laszloh/musical-box/Hardware/Digikey_parts.xlsx

Refes | Description | Partnumber | Link | Supplier | Stückpreis | Menge | Gesamtpreis | Status
U202 | MP2615GQ-P | 1589-MP2615GQ-PCT-ND | https://www.digikey.at/products/de?keywords=1589-MP2615GQ-PCT-ND | Digi-Key | 2.19 | 1 | 2.19 | verfügbar
U203 | TPS56339 | 296-53568-1-ND | https://www.digikey.at/products/de?keywords=296-53568-1-ND | Digi-Key | 0.92 | 1 | 0.92 | verfügbar
U204/U205 | TLV75733PDBV | 296-50414-1-ND | https://www.digikey.at/products/de?keywords=296-53568-1-ND | Digi-Key | 0.42 | 2 | 0.84 | verfügbar
U206 | TLV803EC30DBZR | 296-TLV803EC30DBZRCT-ND | https://www.digikey.at/products/de?keywords=296-50414-1-ND | Digi-Key | 0.36 | 1 | 0.36 | verfügbar
U201 | STUSB4500QTR | 497-18060-1-ND | https://www.digikey.at/product-detail/de/stmicroelectronics/STUSB4500QTR/497-18060-1-ND/9092196 | Digi-Key | 1.73 | 1 | 1.73 | verfügbar
U401 | PCF8574ATS | 568-2030-1-ND | https://www.digikey.at/product-detail/de/nxp-usa-inc/PCF8574ATS-3-118/568-2030-1-ND/812995 | Digi-Key | 1.17 | 1 | 1.17 | verfügbar
U301 | CH340C |  |  | Digi-Key |  | 1 | 0 | nicht verfügabr
U302 | ESP32-WROVER | 1904-1015-1-ND | https://www.digikey.at/products/de?keywords=1904-1015-1-ND | Digi-Key | 4.08 | 0 | 0 | verfügbar
U501 / U502 | SPH0644HM4H-1 | 423-1426-1-ND | https://www.digikey.at/products/de?keywords=423-1426-1-ND | Digi-Key | 1.05 | 2 | 2.1 | verfügbar
U503 | TAS5754MDCA | 296-40564-1-ND | https://www.digikey.at/products/de?keywords=296-40564-1-ND | Digi-Key | 2.92 | 1 | 2.92 | verfügbar
D201 | NTS1045MFST1G | NTS1045MFST1GOSCT-ND | https://www.digikey.at/product-detail/de/on-semiconductor/NTS1045MFST1G/NTS1045MFST1GOSCT-ND/5022594 | Digi-Key | 0.48 | 1 | 0.48 | verfügbar
D204 | NTS1045MFST1G | NTS1045MFST1GOSCT-ND | https://www.digikey.at/product-detail/de/on-semiconductor/NTS1045MFST1G/NTS1045MFST1GOSCT-ND/5022594 | Digi-Key | 0.48 | 1 | 0.48 | verfügbar
Q201 | IRFHM9331TRPBF | IRFHM9331TRPBFCT-ND | https://www.digikey.at/products/de?keywords=IRFHM9331TRPBFCT-ND | Digi-Key | 0.51 | 1 | 0.51 | verfügbar
L202 | SRN6028-6R0M | SRN6028-6R0MCT-ND | https://www.digikey.at/product-detail/de/bourns-inc/SRN6028-6R0M/SRN6028-6R0MCT-ND/4867803 | Digi-Key | 0.38 | 1 | 0.38 | verfügbar
L201 | B82477G4222M000 | 495-77028-1-ND | https://www.digikey.at/product-detail/de/epcos-tdk-electronics/B82477G4222M000/495-77028-1-ND/8601605 | Digi-Key | 1.45 | 1 | 1.45 | verfügbar | 12,3X 12,3
L203 | SRN6028-3R9M | SRN6028-3R9MCT-ND | https://www.digikey.at/product-detail/de/bourns-inc/SRN6028-3R9M/SRN6028-3R9MCT-ND/4867801 | Digi-Key | 0.38 | 1 | 0.38 | verfügbar
P201 | USB4085-GF-A | 2073-USB4085-GF-ACT-ND | https://www.digikey.at/products/de?keywords=2073-USB4085-GF-ACT-ND | Digi-Key | 1.09 | 1 | 1.09 | verfügbar
Q204 | IRF9362TRPBF | IRF9362TRPBFCT-ND | https://www.digikey.at/product-detail/de/infineon-technologies/IRF9362TRPBF/IRF9362TRPBFCT-ND/2354219 | Digi-Key | 0.6 | 1 | 0.6 | verfügbar
Q301 | BC846BDW1T1G | BC846BDW1T1GOSCT-ND | https://www.digikey.at/product-detail/de/on-semiconductor/BC846BDW1T1G/BC846BDW1T1GOSCT-ND/1967038 | Digi-Key | 0.17 | 1 | 0.17 | verfügbar
L501 / L502 / L503 L504 | BWVS006060454R7ML1 | 2184-BWVS006060454R7ML1CT-ND | https://www.digikey.at/product-detail/de/chilisin-electronics/BWVS006060454R7ML1/2184-BWVS006060454R7ML1CT-ND/12141439 | Digi-Key | 0.31 | 4 | 1.24 | verfügbar
J502 / J503 | SJ-43516-SMT-TR | CP-43516SJCT-ND | https://www.digikey.at/products/de?keywords=CP-43516SJCT-ND | Digi-Key | 0.88 | 2 | 1.76 | verfügbar
J201 | 1760510000 | 281-1882-ND | https://www.digikey.at/products/de?keywords=281-1882-ND | Digi-Key | 0.43 | 1 | 0.43 | verfügbar
J501 | EB21A-04-D | 2057-EB21A-04-D-ND | https://www.digikey.at/products/de?keywords=2057-EB21A-04-D-ND | Digi-Key | 0.62 | 1 | 0.62 | verfügbar
J1 | BM02B-GHS-TBT(LF)(SN)(N) | 455-1578-1-ND | https://www.digikey.at/products/de?keywords=455-1578-1-ND | Digi-Key | 0.32 | 1 | 0.32 | verfügbar
J203 | 1760510000 | 281-1882-ND | https://www.digikey.at/products/de?keywords=281-1882-ND | Digi-Key | 0.43 | 1 | 0.43 | verfügbar
J401 | BM08B-GHS-TBT(LF)(SN)(N) | 455-1584-1-ND | https://www.digikey.at/products/de?keywords=455-1584-1-ND | Digi-Key | 0.43 | 1 | 0.43 | verfügbar
J402 /J403/J404/ J405 | BM04B-GHS-TBT(LF)(SN)(N) | 455-1580-1-ND | https://www.digikey.at/products/de?keywords=455-1580-1-ND | Digi-Key | 0.38 | 4 | 1.52 | verfügbar
 |  |  |  |  |  |  | 24.52
RS Components
C211;C212,C505, C506, C527, C528 | 22µF | 1206 | 35V | 788-3063 | https://at.rs-online.com/web/p/keramik-vielschichtkondensatoren/7883063/ | RS | 6
R212 | 100m | 1210 |  | 721-3168 | https://at.rs-online.com/web/p/smd-widerstande/7213168/ | RS | 1
C214, C215, C204, C208, C209; C503, C507, C517, C524, C518, C521 | 1µ | 0603 | 50V | 103-4110 | https://at.rs-online.com/web/p/keramik-vielschichtkondensatoren/1034110/ | RS | 11
C201, C207, C203 | 10µ | 0805 | 35V | 172-6888 | https://at.rs-online.com/web/p/keramik-vielschichtkondensatoren/1726888/ | RS | 3
C202 | 330µ | 10mm | 35V | 172-3820 | https://at.rs-online.com/web/p/aluminium-elektrolytkondensatoren/1723820/ | RS | 1
C222,C218 | 22µF | 0805 | 35V | 915-9334 | https://at.rs-online.com/web/p/keramik-vielschichtkondensatoren/9159334/ | RS | 2
R223 | 30R | 0603 |  | 666-1913 | https://at.rs-online.com/web/p/smd-widerstande/6661913/ | RS | 1
C219, C510, C519 | 100pF | 0603 | 50V | 264-4523 | https://at.rs-online.com/web/p/keramik-vielschichtkondensatoren/2644523/ | RS | 3
R219 | 30,9k | 0603 |  | 840-9228 | https://at.rs-online.com/web/p/smd-widerstande/8409228/ | RS | 1
C217, C220 | 22µF | 0603 | 10V | 144-9046 | https://at.rs-online.com/web/p/keramik-vielschichtkondensatoren/1449046/ | RS | 2
C221, C226, C301, C303, C402, C406 | 10µF | 0603 | 10V | 170-6168 | https://at.rs-online.com/web/p/keramik-vielschichtkondensatoren/1706168/ | RS | 6
R208 | 22k | 0603 |  | 566-973 | https://at.rs-online.com/web/p/smd-widerstande/0566973/ | RS | 1
R201,R215, R205,R222,R213,R214,R220, R211, R509, R513, R312, R407 | 10k | 0603 |  | 740-8892 | https://at.rs-online.com/web/p/smd-widerstande/7408892/ | RS | 12
R216,R209,R204 | 100k | 0603 |  | 213-2531 | https://at.rs-online.com/web/p/smd-widerstande/2132531/ | RS | 3
C213,C206,c224,C216,C223,C225,C227,C210,C205, C501, C502, C504, C526, C302, C305, C306, C304, C401, C404, C405, C403 | 100nF | 0603 | 50V | 133-5641 | https://at.rs-online.com/web/p/keramik-vielschichtkondensatoren/1335641/ | RS | 21
R202 | 470k | 0603 |  | 684-5543 | https://at.rs-online.com/web/p/smd-widerstande/6845543/ | RS | 1
R218,R217,R221,R207,R210, R305, R308, R401, R402, R403, R404, R405, R406, R105 | 1k | 0603 |  | 213-2266 | https://at.rs-online.com/web/p/smd-widerstande/2132266/ | RS | 14
R203,R302, R303 | 470R | 0603 |  | 679-0419 | https://at.rs-online.com/web/p/smd-widerstande/6790419/ | RS | 3
R206 | 100R | 0603 |  | 566-535 | https://at.rs-online.com/web/p/smd-widerstande/0566535/ | RS | 1
R512, R501, R504, R505, r101, R102, R103 | 10R | 0603 |  | 678-9695 | https://at.rs-online.com/web/p/smd-widerstande/6789695/ | RS | 7
R502 | 750k | 0603 |  | 862-7063 | https://at.rs-online.com/web/p/smd-widerstande/8627063/ | RS | 1
R503 | 150k | 0603 |  | 213-2553 | https://at.rs-online.com/web/p/smd-widerstande/2132553/ | RS | 1
C511, C512, C522, C525 | 2,2µF | 0603 | 50V | 170-6267 | 7365617263685F636173636164655F6F726465723D31267365617263685F696E746572666163655F6E616D653D4931384E525353746F636B4E756D626572267365617263685F6C616E67756167655F757365643D656E267365617263685F6D617463685F6D6F64653D6D61746368616C6C267365617263685F7061747465726 | RS | 4
C508, C513, C515, C520 | 220nF | 0603 | 50V | 790-0566 | https://at.rs-online.com/web/p/keramik-vielschichtkondensatoren/7900566/ | RS | 4
C509, C514, C516, C523 | 680nF | 0805 | 50V | 169-6725 | https://at.rs-online.com/web/p/keramik-vielschichtkondensatoren/1696725/ | RS | 4
R506, R507, R510, R511 | 3R3 | 0603 |  | 820-6966 | https://at.rs-online.com/web/p/smd-widerstande/8206966/ | RS | 4
C529, C530, C531, C532 | 10nF | 0603 | 50V | 264-4595 | https://at.rs-online.com/web/p/keramik-vielschichtkondensatoren/2644595/ | RS | 4
R508 | 46,4k | 0603 |  | 708-8921 | https://at.rs-online.com/web/p/smd-widerstande/7088921/ | RS | 1
R304, R309 | 220R | 0603 |  | 566-793 | https://at.rs-online.com/web/p/smd-widerstande/0566793/ | RS | 2
R106, R107 | 4,7k | 0603 |  | 740-8877 | https://at.rs-online.com/web/p/smd-widerstande/7408877/ | RS | 2
