laszloh/musical-box/Hardware/Housing/parts/Side.FCStd

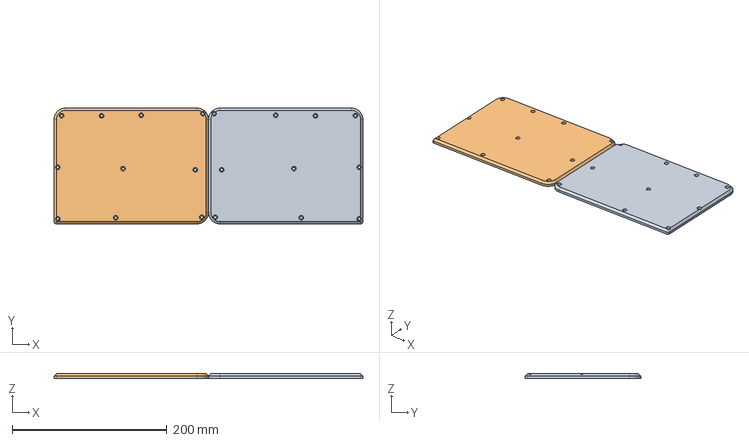
[picture p1: CAD file, 2021-01-16]
Hardware/Housing/parts/Side.FCStd
400.0 x 150.0 x 6.00 mm
Speaker_Side
Speaker_Side (Mirror #1)001
