laszloh/musical-box/Hardware/Housing/parts/deckel.FCStd

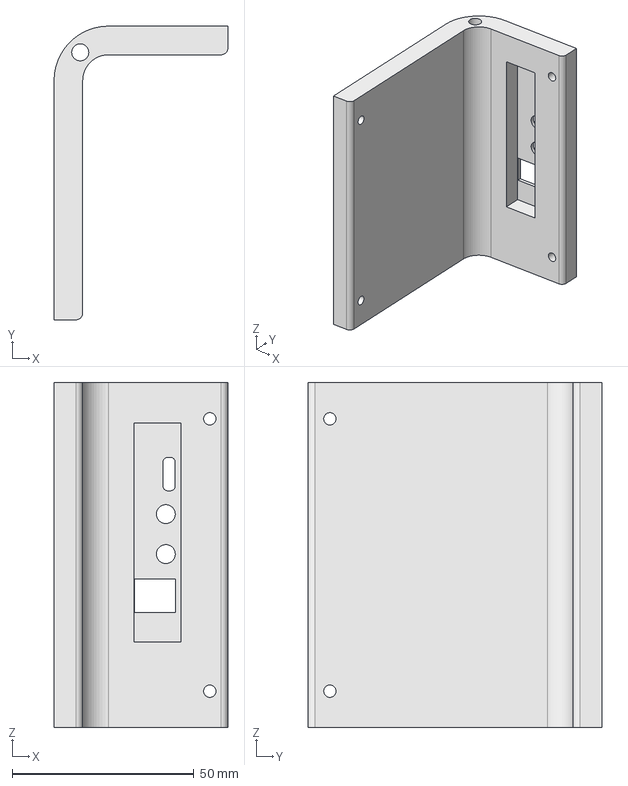
[picture p2: CAD file, 2021-01-16]
Hardware/Housing/parts/deckel.FCStd
47.9 x 80.9 x 95.0 mm
