laszloh/musical-box/Simulation/WS2812/SPI-to-WS2812.asc

C1: cap; 220p
C2: cap; 220p
R1: res; 1.6k
R2: res; 3.3k
U1: 74hc123
U2: 74hc123
U3: 74hc00
U4: 74hc00
U5: 74hc00
U6: 74hc00
V1: voltage; 3.3V
V2: voltage; PULSE(0 3.3V 0 10n 10n {1/(freq*2)} {1/freq})
V3: voltage; PULSE(0 3.3V 0 10n 10n 1.25u 2.5u)
V4: voltage; 0V
Named nets: 0, 5V, CLK, DATA, CS, WS2812
.lib 74HC.lib
.param freq=800k bits=8 bytes=2
.tran 10u
