laszloh/musical-box/Hardware/PCB/musical-box/musical-box.kicad_pcb

## KiCad design Hardware/PCB/musical-box/musical-box.kicad_pcb (2021-06-25)

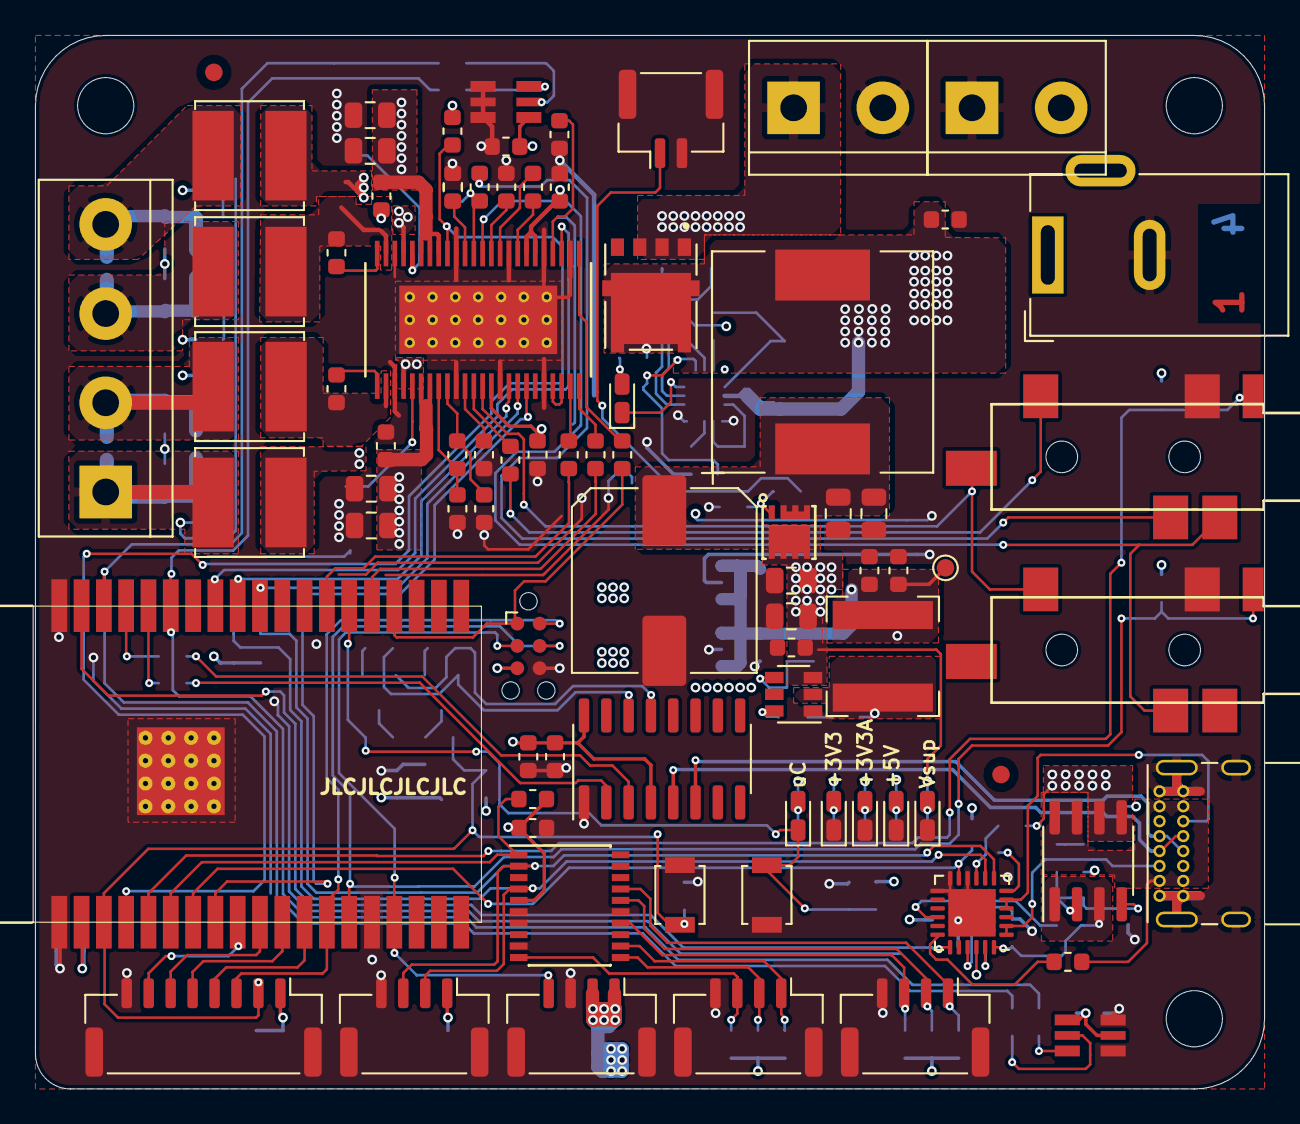
[picture p3: board musical-box.kicad_pcb from above]

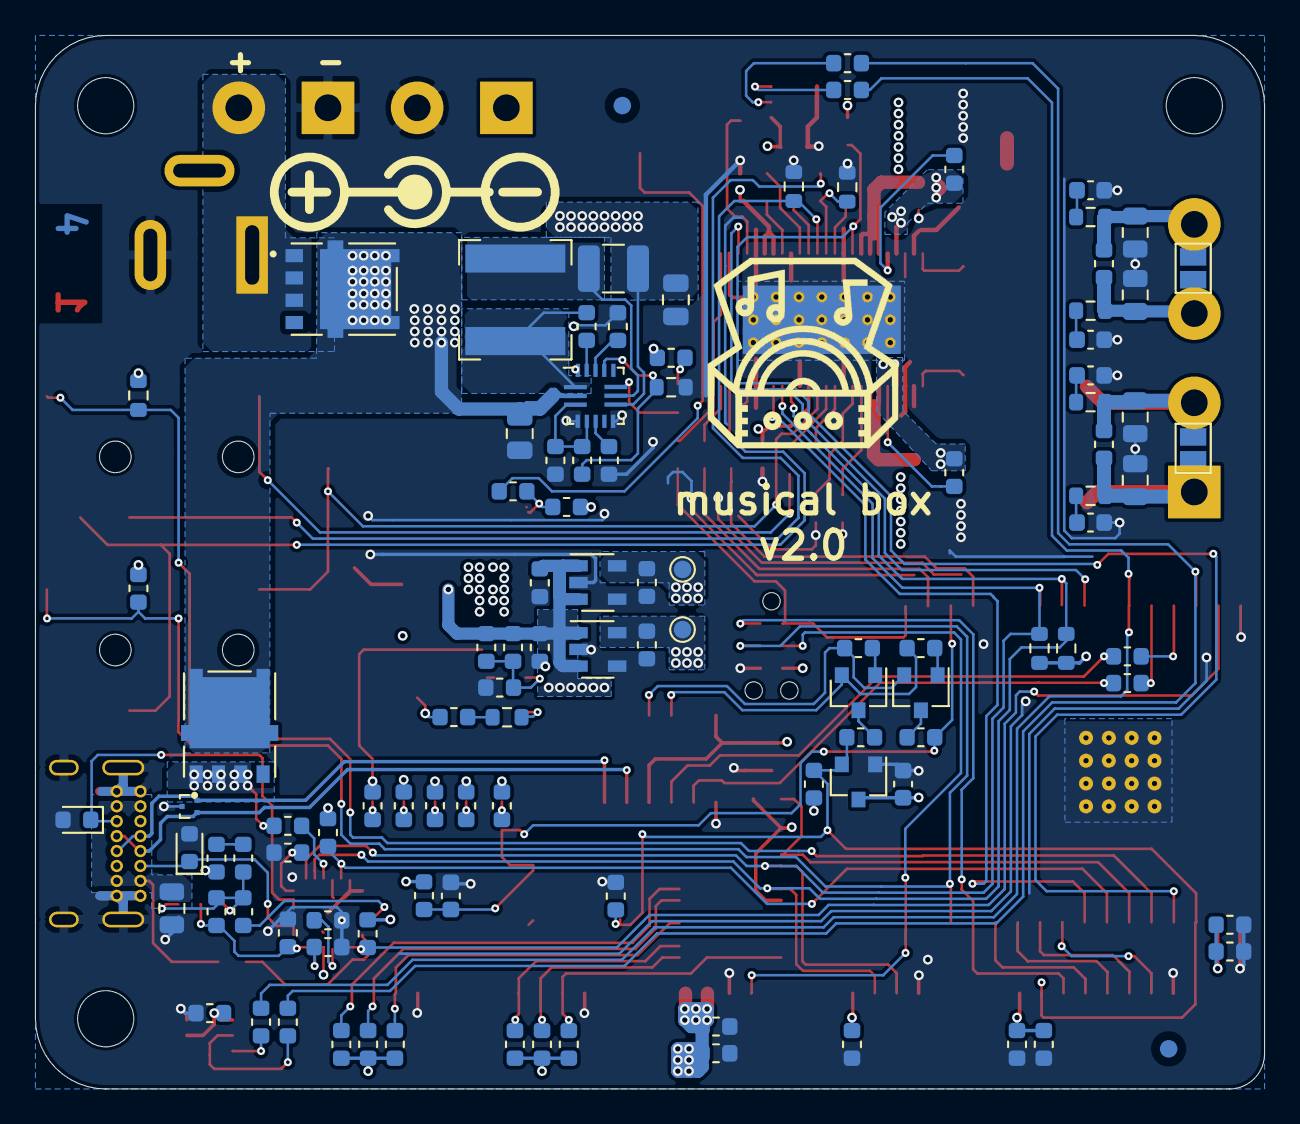
[picture p4: board musical-box.kicad_pcb from below]

Board: 4 copper layers, 70.0 x 60.0 mm, 192 parts (107 on the bottom side), 121 nets.

Parts:
C201, C203, C207, C211, C212, C218, C222, C505, C506, C527, C528: 10u; C_0805_2012Metric
C202: 270u; CP_Elec_10x10
C204, C208, C209, C214, C215, C301, C303, C402, C406, C503, C507, C511, C512, C517, C518, C521, C522, C524, C525: 2.2u; C_0603_1608Metric
C205, C206, C213, C216, C223, C224, C225, C227, C302, C304, C305, C306, C401, C403, C404, C405, C501, C502, C504, C508, C513, C515, C520, C526: 100n; C_0603_1608Metric
C217, C220, C221, C226: 22u; C_0603_1608Metric
C219, C510, C519: 100p; C_0603_1608Metric
C509, C514, C516, C523: 680n; C_0805_2012Metric
C529, C530, C531, C532: 10n; C_0603_1608Metric
D102, D203, D205, D207, D208, D209: LED; LED_0603_1608Metric_Castellated
D201, D204, D210: NTS1045EMFST1G; DIO_NTS1045EMFST1G
D202, D206: 24V; D_0603_1608Metric
FID101, FID102, FID103, FID104: Fiducial; Fiducial_1mm_Mask2mm
H101, H102, H104: MountingHole; MountingHole_3.2mm_M3
J1: power; JST_GH_BM02B-GHS-TBT_1x02-1MP_P1.25mm_Vertical
J201: PSU; TerminalBlock_bornier-2_P5.08mm
J202: Jack-DC; BarrelJack_Wuerth_6941xx301002
J203: BATT; TerminalBlock_bornier-2_P5.08mm
J301: JTAG; Tag-Connect_TC2030-IDC-NL_2x03_P1.27mm_Vertical
J401: SPI Display; JST_GH_BM08B-GHS-TBT_1x08-1MP_P1.25mm_Vertical
J402: Rotary Encoder 1; JST_GH_BM04B-GHS-TBT_1x04-1MP_P1.25mm_Vertical
J403: I2C Display; JST_GH_BM04B-GHS-TBT_1x04-1MP_P1.25mm_Vertical
J404: Rotary Encoder 2; JST_GH_BM04B-GHS-TBT_1x04-1MP_P1.25mm_Vertical
J405: WS2812; JST_GH_BM04B-GHS-TBT_1x04-1MP_P1.25mm_Vertical
J501: spk_out; TerminalBlock_bornier-4_P5.08mm
J502: aux in; PJ328B
J503: line out; PJ328B
JP3, JP4: mono; SolderJumper-2_P1.3mm_Open_Pad1.0x1.5mm
L201: 2,2u; L_12x12mm_H8mm
L202, L203: 6.8u; L_Bourns-SRN6028
L501, L502, L503, L504: 4.7u; L_Bourns_SRN6045TA
P201: USB_C; USB_C_Receptacle_GCT_USB4085
P202, P203, P204: ICT-Point; TestPoint_Pad_D1.0mm
Q201: IRFHM9331; PQFN-3x3
Q204: IRF9362; SOIC-8_3.9x4.9mm_P1.27mm
Q301, Q302: BC848; SOT-23
R101, R102, R103, R223, R501, R504, R505, R512: 10R; R_0603_1608Metric
R105, R106, R107, R207, R210, R217, R218, R221, R222, R305, R308, R312, R401, R402, R403, R404, R405, R406: 1k; R_0603_1608Metric
R201, R203, R205, R208, R209, R211, R213, R214, R215, R216, R220, R407, R409, R508, R509, R513: 10k; R_0603_1608Metric
R202, R204: 100k; R_0603_1608Metric
R206, R302, R303, R304, R309: 220R; R_0603_1608Metric
R212: 100mR; R_1210_3225Metric
R219: 52.3k; R_0603_1608Metric
R408, R410: 50m; R_0603_1608Metric
R502: 750k; R_0603_1608Metric
R503: 150k; R_0603_1608Metric
R506, R507, R510, R511: 3.3R; R_0603_1608Metric
SW301: boot; SW_SPST_B3U-1000P
SW302: reset; SW_SPST_B3U-1000P
U201: STUSB4500QTR; QFN-24-1EP_4x4mm_P0.5mm_EP2.7x2.7mm
U202: MP2615; QFN-16_2.9x2.9_Pitch0.5mm
U203: TPS56339; SOT-23-6
U204, U205: TLV75733PDBV; SOT-23-5
U206: TLV803EC30DBZR; SOT-23
U207: TPD2EUSB30A; Texas_DRT-3
U301: CH340C; SOIC-16_3.9x9.9mm_P1.27mm
U302: ESP32-WROVER
U401: PCF8574ATS; SSOP-20_4.4x6.5mm_P0.65mm
U501, U502: SPH0644HM4H-1
U503: TAS5754MDCA

Connections:
+3.3VA: C226.2, C501.1, C502.1, C507.1, P203.1, R221.2, U205.5, U501.1, U501.5, U502.1, U503.14
+3V3: C221.2, C227.2, C301.1, C302.1, C303.1, C304.1, C401.1, C402.1, C403.1, C404.1, C524.1, J301.5, J401.1, J403.1, P202.1, R105.2, R106.2, R107.2, R213.1, R214.1, R217.2, R222.1, R312.2, R401.1, R402.1, R403.1, R404.1, R405.1, R406.1, R407.1, R508.2, R509.2, R513.2, U201.22, U204.5, U206.3, U301.4, U301.16, U302.2, U401.5, U503.30, U503.31
+5V: C217.2, C219.2, C220.2, C223.2, C225.2, C405.1, C406.1, J405.1, J405.2, L203.2, P204.1, R218.2, R219.1, U204.1, U204.3, U205.1, U205.3
+15V: C218.2, C222.2, C224.2, C504.1, C505.1, C506.1, C526.1, C527.1, C528.1, Q201.3, R201.2, U203.3, U503.6, U503.7, U503.41, U503.42, U503.43
/Audio Output/AUX_Detect: J502.S, R513.1, U302.5
/Audio Output/DAC_OUTA: J502.TN, J503.T, U503.13
/Audio Output/DAC_OUTB: J502.R1N, J503.R1, R409.2, U503.36
/Audio Output/GPIO0: U302.8, U503.18
/Audio Output/GPIO2: U503.21, U503.22
/Audio Output/LRCLK: R101.1, U503.25
/Audio Output/OUT1+: C509.1, C510.1, J501.1, JP3.1, L501.2, R506.2
/Audio Output/OUT1-: C510.2, C514.1, J501.2, JP3.2, L502.2, R507.2
/Audio Output/OUT2+: C519.2, C523.1, J501.4, JP4.2, L504.2, R511.2
/Audio Output/OUT2-: C516.1, C519.1, J501.3, JP4.1, L503.2, R510.2
/Audio Output/SCLK: R102.1, U503.23
/Audio Output/SDIN: R103.1, U503.24
/Audio Output/SPKA_OUT+: C508.1, L501.1, U503.4
/Audio Output/SPKA_OUT-: C513.1, L502.1, U503.2
/Audio Output/SPKB_OUT+: C520.1, L504.1, U503.45
/Audio Output/SPKB_OUT-: C515.1, L503.1, U503.47
/Audio Output/SPK_INA: C511.1, J502.T
/Audio Output/SPK_INB: C525.2, J502.R1
/Audio Output/SPK_INB+: C525.1, R408.2, U503.37
/Audio Output/SPK_INB-: C522.2, R410.2, U503.38
/Microcontroller/D+: P201.A6, P201.B6, U207.1, U301.5
/Microcontroller/D-: P201.A7, P201.B7, U207.2, U301.6
/Microcontroller/DTR: Q302.2, R305.2, U301.13
/Microcontroller/I34: R407.2, U302.6, U401.1
/Microcontroller/I35: R214.2, U201.11, U302.7
/Microcontroller/I36: R508.1, U302.4, U503.40
/Microcontroller/IO00: C305.1, D102.1, R309.1, R312.1, SW301.2, U302.25
/Microcontroller/IO02: R103.2, U302.24
/Microcontroller/IO04: R102.2, U302.26
/Microcontroller/IO05: J403.3, R106.1, U201.7, U302.29, U401.2, U503.17
/Microcontroller/IO12: J301.4, J503.S, R509.1, U302.14
/Microcontroller/IO13: J301.3, J405.4, U302.16
/Microcontroller/IO14: J301.2, J401.3, U302.13
/Microcontroller/IO15: J301.1, R101.2, U302.23
/Microcontroller/IO18: J403.2, R107.1, U201.8, U302.30, U401.4, U503.16
/Microcontroller/IO19: U302.31, U503.27
/Microcontroller/IO21: R501.2, R505.2, U302.33
/Microcontroller/IO22: R504.2, R512.2, U302.36
/Microcontroller/IO23: R213.2, U201.19, U302.37
/Microcontroller/IO25: J401.6, U302.10
/Microcontroller/IO26: J401.5, U302.11
/Microcontroller/IO27: J401.4, U302.12
/Microcontroller/RTS: Q301.2, R308.2, U301.14
/Microcontroller/RXD0: R302.1, U302.34
/Microcontroller/TXD0: R303.1, U302.35
/Microcontroller/~RESET: C306.1, J401.2, R222.2, R304.2, SW302.2, U206.2, U302.3
/User Interface/BLED: J401.7, U302.9
GND: C201.1, C202.2, C203.1, C204.2, C206.1, C207.1, C208.2, C209.2, C211.1, C212.1, C214.1, C215.1, C217.1, C218.1, C220.1, C221.1, C222.1, C223.1, C224.1, C225.1, C226.1, C227.1, C301.2, C302.2, C303.2, C304.2, C305.2, C306.2, C401.2, C402.2, C403.2, C404.2, C405.2, C406.2, C501.2, C502.2, C503.2, C504.2, C505.2, C506.2, C507.2, C509.2, C512.1, C514.2, C516.2, C517.2, C521.2, C522.1, C523.2, C524.2, C526.2, C527.2, C528.2, C529.2, C530.2, C531.2, C532.2, D202.2, D203.1, D206.2, D207.1, D208.1, D209.1, J1.2, J1.MP, J201.1, J202.2, J203.2, J301.6, J401.8, J401.MP, J402.4, J402.MP, J403.4, J403.MP, J404.4, J404.MP, J405.3, J405.MP, J502.R2, J503.R2, P201.A1, P201.A12, P201.B1, P201.B12, P201.S1, R203.2, R209.2, R216.1, R220.1, R408.1, R409.1, R410.1, R502.1, SW301.1, SW302.1, U201.10, U201.12, U201.13, U201.25, U202.4, U202.8, U202.16, U203.1, U204.2, U204.4, U205.2, U205.4, U206.1, U207.3, U301.1, U302.1, U302.15, U302.38, U302.39, U401.6, U401.7, U401.9, U401.15, U501.4, U501.6, U502.4, U502.5, U502.6, U503.3, U503.10, U503.15, U503.20, U503.26, U503.29, U503.33, U503.39, U503.46, U503.EPAD
unnamed: C201.2, C202.1, C207.2, L201.2, Q201.2, R202.2
unnamed: C203.2, P201.A4, P201.A9, P201.B4, P201.B9, Q204.7, Q204.8, R207.1
unnamed: C204.1, Q204.1, Q204.3, R204.1, U201.24
unnamed: C205.1, R206.1
unnamed: C206.2, C211.2, D201.1, D204.1, D210.1, L201.1, R211.2, U202.2
unnamed: C208.1, U201.21
unnamed: C209.1, U201.23
unnamed: C212.2, D204.2, J203.1, R212.2, U202.9
unnamed: C213.1, U202.15
unnamed: C213.2, L202.1, U202.1
unnamed: C215.2, U202.14
unnamed: C216.1, R223.1
unnamed: C216.2, L203.1, U203.2
unnamed: C219.1, R219.2, R220.2, U203.4
unnamed: C503.1, R503.2, U503.8
unnamed: C508.2, U503.5
unnamed: C511.2, U503.12
unnamed: C512.2, U503.11
unnamed: C513.2, U503.1
unnamed: C515.2, U503.48
unnamed: C517.1, U503.28
unnamed: C518.1, U503.32
unnamed: C518.2, U503.34
unnamed: C520.2, U503.44
unnamed: C521.1, U503.35
unnamed: C529.1, R506.1
unnamed: C530.1, R507.1
unnamed: C531.1, R510.1
unnamed: C532.1, R511.1
unnamed: D102.2, R105.1
unnamed: D201.2, J201.2, J202.1
unnamed: D202.1, P201.B5, U201.4, U201.5
unnamed: D203.2, R201.1
unnamed: D205.1, U202.11
unnamed: D205.2, R211.1
unnamed: D206.1, P201.A5, U201.1, U201.2
unnamed: D207.2, R217.1
unnamed: D208.2, R218.1
unnamed: D209.2, R221.1
unnamed: J1.1, R205.1
unnamed: J402.1, R401.2, U401.12
unnamed: J402.2, R402.2, U401.11
unnamed: J402.3, R403.2, U401.10
unnamed: J404.1, R404.2, U401.17
unnamed: J404.2, R405.2, U401.16
unnamed: J404.3, R406.2, U401.14
unnamed: L202.2, R212.1, U202.10
unnamed: Q201.1, R202.1, R205.2
unnamed: Q204.2, Q204.4, R204.2, R206.2, R208.1
unnamed: Q301.1, R305.1
unnamed: Q301.3, R304.1
unnamed: Q302.1, R308.1
unnamed: Q302.3, R309.2
unnamed: R203.1, R215.2, U202.13
unnamed: R207.2, U201.18
unnamed: R208.2, U201.16
unnamed: R209.1, U201.6
unnamed: R210.2, U201.9
unnamed: R216.2, U202.6
unnamed: R223.2, U203.6
unnamed: R302.2, U301.2
unnamed: R303.2, U301.3
unnamed: R501.1, U501.3
unnamed: R502.2, R503.1, U503.9
unnamed: R504.1, U502.2
unnamed: R505.1, U502.3
unnamed: R512.1, U501.2
VCC: C214.2, R215.1, U202.3, U202.5
VDC: C205.2, D210.2, Q204.5, Q204.6, R210.1
