laszloh/musical-box/Software/snapcast/components/musical-box/musical_box_v1_0/board_def.h

/*
 * ESPRESSIF MIT License
 *
 * Copyright (c) 2020 <ESPRESSIF SYSTEMS (SHANGHAI) CO., LTD>
 *
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
 */

#ifndef _AUDIO_BOARD_DEFINITION_H_
#define _AUDIO_BOARD_DEFINITION_H_

#define BUTTON_VOLUP_ID           0
#define BUTTON_VOLDOWN_ID         1
#define BUTTON_MUTE_ID            2
#define BUTTON_SET_ID             3

#define PA_ENABLE_GPIO            GPIO_NUM_12
#define ADC_DETECT_GPIO           GPIO_NUM_36
#define BATTERY_DETECT_GPIO       GPIO_NUM_37

#define SDCARD_OPEN_FILE_NUM_MAX  5
#define SDCARD_INTR_GPIO          -1


extern audio_hal_func_t AUDIO_CODEC_PCM514X_DEFAULT_HANDLE;

#define AUDIO_CODEC_DEFAULT_CONFIG(){                   \
        .adc_input  = AUDIO_HAL_ADC_INPUT_LINE1,        \
        .dac_output = AUDIO_HAL_DAC_OUTPUT_ALL,         \
        .codec_mode = AUDIO_HAL_CODEC_MODE_BOTH,        \
        .i2s_iface = {                                  \
            .mode = AUDIO_HAL_MODE_SLAVE,               \
            .fmt = AUDIO_HAL_I2S_NORMAL,                \
            .samples = AUDIO_HAL_48K_SAMPLES,           \
            .bits = AUDIO_HAL_BIT_LENGTH_16BITS,        \
        },                                              \
};

#define INPUT_KEY_NUM     1

#define INPUT_KEY_DEFAULT_INFO() {                      \
    {                                                   \
        .type = PERIPH_ID_BUTTON,                       \
        .user_id = INPUT_KEY_USER_ID_ROT,               \
        .act_id = BUTTON_ROT_ID,                        \
    },                                                  \
}

#endif
