laszloh/musical-box/(commit log)

2020-07-25 Add framework for project
    Add the framework for the project and add the needed submodules and ingores for the KiCad project.
    [audi_output.sch, core.sch, musical-box.kicad_pcb, musical-box.sch, power_supply.sch, user_interface.sch]
2020-07-28 Add Software framework
    Add the Software framework. Custom PIO platform for ADF does not yet work. Need more work
2020-07-29 prepare software framework
2020-07-31 Start the schematic development
    Start work on the ESP and the audio output schematic
    [audi_output.sch, core.sch, musical-box.sch, power_supply.sch, user_interface.sch]
2020-07-31 Add MIC ADC
    Add the PCM1865 as the microphone ADC. It's still an open question, if
    it'll work.
    ToDo:
    check I2S data format, if it supports 4 channels in a 2x32bit frame
    [audi_output.sch, core.sch, musical-box.sch]
2020-08-03 Upload of the weekend work
    [audi_output.sch, core.sch, musical-box.sch, user_interface.sch]
2020-08-03 Further work on schematic done
    Pinout, outputs, UI is mostly finished. Power supply still missing.
    Free as many pins for JTAG as possible.
    [audi_output.sch, core.sch, musical-box.sch, power_supply.sch, user_interface.sch]
2020-08-04 Add 2 MEMS Mic's and change WS2812 driver to SPI
    Add 2 MEMS Microphones to the 2nd I2S channel and change the WS2812
    driver to use Monoflops and the SPI bus. Currently not the best
    solution.
    -) Check memory footprint of the solution using the RMT module of the
    esp32 for the signal generation
    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
    [audi_output.sch, core.sch, musical-box.sch, user_interface.sch]
2020-08-05 Small schematic update
    [audi_output.sch, musical-box.sch, power_supply.sch, user_interface.sch]
2020-08-05 Update gitignore for LTSpice
    Update gitinore for LTSpice files and fix the monistable
    multivibrator values
    [audi_output.sch, power_supply.sch, user_interface.sch]
2020-08-24 Work on the schematic and the layout
    [audi_output.sch, core.sch, musical-box.kicad_pcb, musical-box.sch, power_supply.sch, user_interface.sch]
2020-08-26 Add ADF software framework
2020-08-28 Add board def files
2020-09-01 layout start
    layout start
    [audi_output.sch, core.sch, musical-box.kicad_pcb, musical-box.sch, power_supply.sch, user_interface.sch]
2020-09-01 nightly commit -- squash me later
    [audi_output.sch, musical-box.kicad_pcb, power_supply.sch]
2020-09-02 Update schematic for new I2S amplifier
    [audi_output.sch, core.sch, musical-box.sch, power_supply.sch]
2020-09-02 Add 2S LiIon battery charger and assing missing footprints
    [audi_output.sch, core.sch, musical-box.sch, power_supply.sch, user_interface.sch]
2020-09-02 Rework USB-C power device schematic
    Rework the power device schematic to represent the typical application
    from the datasheet. Also remove all local footprint libraries.
    [audi_output.sch, core.sch, musical-box.sch, power_supply.sch, user_interface.sch]
2020-09-03 Fix short between SCL and SDA in netlist
    [musical-box.sch]
2020-09-04 Start to add purchase numbers for the parts
    Start to select real parts from rs-components and digikey. Footprints were updated to reflect smaller package sizes found.
    [audi_output.sch, core.sch, musical-box.sch, power_supply.sch, user_interface.sch]
2020-09-08 Add two buttons for reset and bootloader
    [core.sch, power_supply.sch]
2020-12-15 Add new schematic and layout framework
    [musical-box.kicad_pcb, musical-box.sch, power_supply.sch]
2020-12-19 Change the audio jack to a cheaper one from ali
    [audi_output.sch, core.sch, musical-box.kicad_pcb, musical-box.sch]
2020-12-23 Start working on placement and layout
    [audi_output.sch, core.sch, musical-box.kicad_pcb, musical-box.sch, power_supply.sch, user_interface.sch]
2020-12-25 Finish v1 layout
    Cleanup still needed
    [audi_output.sch, core.sch, musical-box.kicad_pcb, musical-box.sch, power_supply.sch, user_interface.sch]
2020-12-25 Add 3D models nd swap USB C connector to an avaliable one
    [musical-box.kicad_pcb, power_supply.sch, user_interface.sch]
2020-12-26 Start the work on the software framework
2020-12-26 Add ideal diodes with LTC4412 & IRF9362TRPBF instead of real diodes
    [audi_output.sch, core.sch, musical-box.kicad_pcb, musical-box.sch, power_supply.sch, user_interface.sch]
2020-12-26 Further work on the layout
    Get back to diodes, since they are cheaper
    [musical-box.kicad_pcb, power_supply.sch]
2020-12-29 Reduce PCB by 15mm on one edge
    New PCB size is 70x60mm through better positioning and higher packing
    ratio.
    [audi_output.sch, core.sch, musical-box.kicad_pcb, musical-box.sch, power_supply.sch, user_interface.sch]
2020-12-30 No unconnected nets any more
    [audi_output.sch, musical-box.kicad_pcb, musical-box.sch, user_interface.sch]
2020-12-30 Layout optimizations
    [musical-box.kicad_pcb]
2021-01-03 Layout optimisations
    [audi_output.sch, musical-box.kicad_pcb, musical-box.sch, user_interface.sch]
2021-01-06 layoutoptimisation and review
    [musical-box.kicad_pcb]
2021-01-06 Start layout rework
    Added AUX-in connector and changed line in to have only a single
    connector type. Due to the change, the power part has to be reworked.
    First part placement is finished, layout work still ongoing.
    [audi_output.sch, musical-box.kicad_pcb, musical-box.sch, power_supply.sch]
2021-01-07 Change Capatictor size to 0805
    Reduce the package size of the input filter capacitors
    [musical-box.kicad_pcb, power_supply.sch]
2021-01-07 Connect Line and AUX in detect to VDD3D
    [audi_output.sch]
2021-01-07 Route power LEDs
    [musical-box.kicad_pcb]
2021-01-07 Route the USB-Serial converter and port expander
    [musical-box.kicad_pcb]
2021-01-07 Route the VDD3A lines
    [musical-box.kicad_pcb]
2021-01-07 Route audio signals
    [musical-box.kicad_pcb]
2021-01-07 Fix battery charger circuit
    [musical-box.kicad_pcb]
2021-01-07 Swap aux and line detect for better routing
    [audi_output.sch, musical-box.kicad_pcb, musical-box.sch]
2021-01-07 Route aux and line detect
    [musical-box.kicad_pcb]
2021-01-07 Route Reset and IO0 stubs
    [musical-box.kicad_pcb]
2021-01-07 Fix Poly fills and add silk screen information
    [musical-box.kicad_pcb]
2021-01-07 Swap Q201 to DMP3013SFK since the old one has a EOL PCN
    [audi_output.sch, power_supply.sch]
2021-01-07 Add 3D models for the remaining parts
    [musical-box.kicad_pcb]
2021-01-07 Add partnumber and supplier for audio jack
    [audi_output.sch]
2021-01-07 Add 3D models and update library
    [musical-box.kicad_pcb]
2021-01-07 Increase track width in inner layers to match needed current capabilities
    [musical-box.kicad_pcb]
2021-01-07 Add logo and version text to PCB
    [musical-box.kicad_pcb]
2021-01-09 review of layout optimizing routing
    [musical-box.kicad_pcb]
2021-01-09 shielding between i2s lines
    [musical-box.kicad_pcb]
2021-01-09 Fix: Change 3D path of audio jacks to relative
    [musical-box.kicad_pcb]
2021-01-09 Fix: Set Pin EN of U203 to DNC
    TPS56339 EN Pin set to DNC
    [musical-box.kicad_pcb, power_supply.sch, user_interface.sch]
2021-01-09 Fix: VFB Resistor change to 30.9k
    VFB Resistor R219 changed to 30.9k
    [power_supply.sch]
2021-01-09 Fix: VBST series resistor added
    TPS56339 VBST series resisor R223 added
    [musical-box.kicad_pcb, power_supply.sch]
2021-01-10 Fix: VBUS EN resistor changed
    STUSB4500QTR VBUS_EN_SNK R206 changed to 100R
    [core.sch, power_supply.sch]
2021-01-10 Create Digikey_parts.xlsx
    Digikey Partlist
    [Digikey_parts.xlsx]
2021-01-12 Update Digikey_parts.xlsx
    Update Digikey Parts
    [Digikey_parts.xlsx]
2021-01-13 Swap J203 to a screwing block
    [musical-box.kicad_pcb, power_supply.sch]
2021-01-13 Swap Q201 to IRFHM9331
    [musical-box.kicad_pcb, power_supply.sch]
2021-01-14 Update footprints with the correct heat slugs and stencils
    [musical-box.kicad_pcb]
2021-01-14 Add 3D model of PCB
    [musical-box.kicad_pcb]
2021-01-15 Routing optimization to increase bottom GND pour around Audio AMP
    [musical-box.kicad_pcb]
2021-01-15 Add shielding to high frequency nets
    [musical-box.kicad_pcb, user_interface.sch]
2021-01-15 Add plain side for Speaker
    Add a plain side with holes for M3 ISO 4762 screws for the speaker body https://www.thingiverse.com/thing:4692880
    [Side.FCStd]
2021-01-15 Round the PCB corners
    (cherry picked from commit 10227c025a6ee98868355f93265f09cbc06648e2)
    [musical-box.kicad_pcb]
2021-01-15 Add layer markers to pcb
    [musical-box.kicad_pcb]
2021-01-15 Remove unused git attribute and filter functions
2021-01-16 Add resistors to enable PBTL mode of the TAS5754M
    (cherry picked from commit 301159c7868d971a4884b90c71ce5df5829b466a)
    [audi_output.sch, musical-box.kicad_pcb, power_supply.sch, user_interface.sch]
2021-01-16 Add barrel jack polarity symbol
    (cherry picked from commit 159b1489efe9453d27f0acdcd18ccf6335c51b1f)
    [musical-box.kicad_pcb]
2021-01-16 Fix: Add correct files to enable PBTL
    (cherry picked from commit 20c2b4c278d97c62a54a61cca38bbc54ec631a1d)
    [audi_output.sch]
2021-01-16 Update Sides to fit the housing and add a cover with coutouts for the PCB
    [Side.FCStd, deckel.FCStd]
2021-01-25 Modify copper pour to reduce marrow corssings
    At the liIon there are some narrow parts in the copper pour. This commit
    increases the pour
    [musical-box.kicad_pcb]
2021-02-10 RS components added
    [Digikey_parts.xlsx]
2021-02-18 Fix error in schematic
    The P-Channel MOSFet was connected in the wrong way, preventing the shutoff circuit from working properly
    [musical-box.kicad_pcb, power_supply.sch]
2021-02-18 CHange values to fit the TPS56339
    [power_supply.sch]
2021-02-19 Bugfix: Add connection to VDD to supply the PD device
    [musical-box.kicad_pcb, power_supply.sch]
2021-02-20 Adapt values to real population
    [audi_output.sch, core.sch, power_supply.sch]
2021-02-20 Addendum to 9e53ee1
    [musical-box.kicad_pcb]
2021-02-20 Remove needless vias
    [musical-box.kicad_pcb]
2021-02-20 Add I2C scanner test tool
2021-02-21 Reduce part diversity
    [audi_output.sch]
2021-02-21 Bugfix: Fix speaker B connection to make the output work
    [audi_output.sch, musical-box.kicad_pcb]
2021-02-21 Reduce part count on the USB PD device and add some ESD protection
    [audi_output.sch, musical-box.kicad_pcb, power_supply.sch]
2021-02-21 Reduce number of unique parts
    [audi_output.sch, core.sch, musical-box.kicad_pcb, musical-box.sch, power_supply.sch, user_interface.sch]
2021-02-23 Change 22uF capacitors to 2.2uF to reduce costs
    [audi_output.sch, core.sch, user_interface.sch]
2021-02-23 Add JTAG connector and move to SOT-23 single transistors
    [audi_output.sch, core.sch, musical-box.kicad_pcb, musical-box.sch]
2021-02-28 Bugfix: Missing NTC voltage divider added
    [musical-box.kicad_pcb, power_supply.sch]
2021-03-03 fix error in mono setup
    [audi_output.sch, core.sch, musical-box.kicad_pcb]
2021-06-25 Add additional diode to isolate USB-C from the main power supply
    [audi_output.sch, core.sch, musical-box.kicad_pcb, musical-box.sch, power_supply.sch, user_interface.sch]
